lucasnoce/TFG_LevelSensingDevice/Results/fig_placa_teste.jpeg

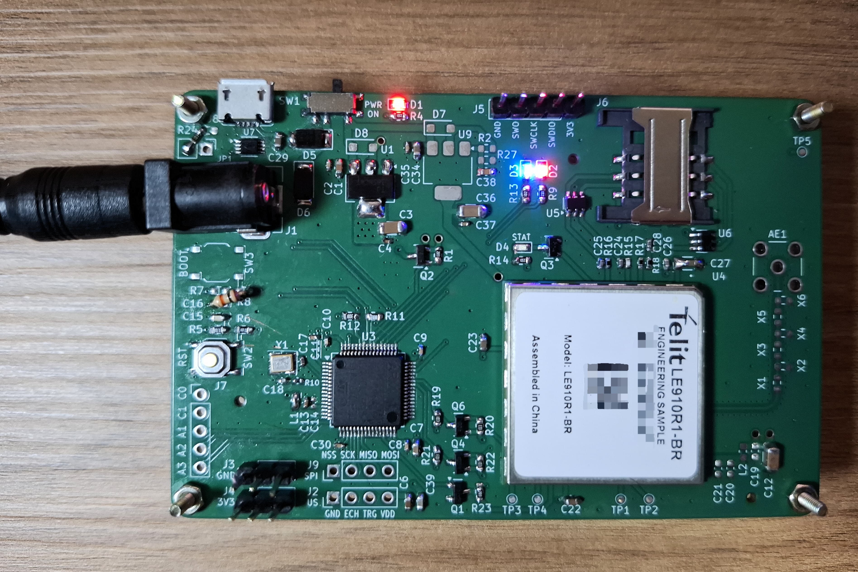
Results/fig_placa_teste.jpeg
