lucasnoce/TFG_LevelSensingDevice/README.md

# Level Sensing Device

Desenvolvido como meu Trabalho Final de Graduação, este dispositivo foi projetado para realizar medições de nível utilizando diferentes sensores, como sensores de Tempo de Voo (TOF) e Ultrassônicos. Ele também integra um modem LTE para transmitir os dados de medição por meio das tecnologias 4G e 2G. Além dos sensores de nível, o dispositivo também conta com um sensor de temperatura/umidade para melhorar o desempenho do sensoriamento ultrassônico.

Para informações mais detalhadas, consulte o [artigo completo](Results/Artigo_rev9.pdf).

---

Developed for my final Graduation Project, this device is designed to take level measurements using different sensors such as Time Of Flight (TOF) and Ultrasonic sensors. It also integrates an LTE modem to transmit the measurement data through 4G and 2G technologies. Besides de level sensors, the device also features a temperature/humidity sensor to help provide better ultrasonic sensing performance.

For more detailed information, please refer to the detailed [paper](Results/Artigo_rev9.pdf).
