lucasnoce/TFG_LevelSensingDevice/Results/Artigo_rev9.pdf

# Desenvolvimento de Dispositivo IoT para Monitoramento de Recursos Hídricos

Lucas A. Noce
Instituto de Engenharia de Sistemas e Tecnologia da Informaçaõ Universidade Federal de Itajubá Itajuba, MG ´
lucas.noce@unifei.edu.br
Decio Renn ´ | o M. Faria ´
Instituto de Engenharia de Sistemas e Tecnologia da Informaçaõ Universidade Federal de Itajubá Itajuba, MG ´
deciorenno@unifei.edu.br

Resumo—O avanço da Internet das Coisas (IoT) tem impulsionado a integraçao de conectividade em sensores inteligentes, ˜ especialmente em dispositivos autonomos projetados para o ˆ monitoramento remoto de locais de difícil acesso. Novas tecnologias de comunicaçao m ˜ ovel vem sendo desenvolvidas com ´ foco nesses equipamentos, visando o equilíbrio entre consumo e taxa de dados. Dentre essas aplicaçoes, o gerenciamento de ˜ recursos hídricos tem ganhado relevancia por conta da crescente ˆ demanda por soluçoes de monitoramento ambiental, decorrente ˜
da intensificaçao das emerg ˜ | encias clim ˆ | aticas. Nesse sentido, o ´
presente trabalho apresenta o desenvolvimento de um dispositivo
versatil voltado ´ | a supervis ` | ao remota de recursos h ˜ | ídricos.
Palavras-chave—Sensor de nível, Monitoramento remoto, Internet das Coisas.
Abstract—Advances in the development of the Internet of Things (IoT) have driven the integration of connectivity into smart sensors, especially in autonomous devices designed for remote monitoring of hard-to-reach locations. New mobile communication technologies have been developed with a focus on these devices, aiming to balance consumption and data rate. Among these applications, water resource management has gained relevance due to the growing demand for environmental monitoring solutions, resulting from the intensification of climate emergencies. In this sense, this paper will develop a versatile device aimed at remote supervision of water resources. Keywords—Level sensor, Remote monitoring, Internet of Things.
I. INTRODUÇ AÕ

A Internet das Coisas (IoT) tem se destacado como uma area ´ importante da tecnologia, permitindo a integraçao de diversos ˜ dispositivos e sensores para coletar e transmitir dados de maneira eficaz [1]. Neste contexto, a capacidade de monitorar e controlar variaveis ambientais de forma remota tem se ´ mostrado cada vez mais valiosa [2].
Esta crescente importancia da IoT se reflete na demanda ˆ
por soluçoes que ofereçam n ˜ | ao apenas conectividade, mas ˜
tambem precis ´ | ao e confiabilidade na coleta e transmiss ˜ | ao de ˜
dados [3]. Em locais de difícil acesso, como zonas rurais, ambientes industriais complexos ou areas geograficamente ´ isoladas, a capacidade de monitorar remotamente variaveis ´ ambientais se torna crucial para a manutençao da segurança, ˜
eficiencia e sustentabilidade das operaç ˆ | oes [ ˜ | 4]. Ate mesmo ´

Este projeto foi parcialmente viabilizado pela empresa Telit Cinterion, que forneceu o modem LE910R1BR utilizado durante o desenvolvimento.

as regioes urbanas t ˜ | em sofrido cada vez mais com os efeitos ˆ
das emergencias clim ˆ | aticas e buscado implementar soluç ´ | oes ˜
voltadas ao escoamento urbano que se beneficiam do monitoramento remoto contínuo [5].
Isso porque o monitoramento de recursos hídricos, que
consiste na coleta e analise de dados relacionados ´ | a qualidade, `
quantidade e dinamica da ˆ | agua em diferentes ambientes, ´
e essencial para a gest ´ | ao sustent ˜ | avel desses recursos [ ´ | 6],
permitindo identificar mudanças no nível da agua, prever ´ enchentes e avaliar a disponibilidade hídrica. Por conta disso,
essas soluçoes s ˜ | ao muito utilizadas em diversas aplicaç ˜ | oes ˜
como no acompanhamento do nível de reservatorios para ´
abastecimento publico, detecç ´ | ao de variaç ˜ | oes em rios para ˜
prevenir desastres naturais e controle de sistemas de irrigaçaõ
em areas agr ´ | ícolas [7].
| Nesse sentido, a integraçao desses dispositivos de moni- ˜
toramento com tecnologias de comunicaçao sem fio, como ˜ GSM (Global System for Mobile Communications, tecnologia de 2G amplamente utilizada para transmissao de dados ˜
em regioes remotas) e LTE ( ˜ | Long-Term Evolution, padraõ
de comunicaçao m ˜ | ovel de 4G que combina alta velocidade ´
com maior eficiencia energ ˆ | etica para IoT) se torna essencial. ´
Quando alinhadas a plataformas de gerenciamento de dados, essas tecnologias desempenham um papel fundamental na
organizaçao e interpretaç ˜ | ao dos dados, garantindo que as ˜
informaçoes sejam disponibilizadas de forma oportuna para ˜
os responsaveis pela operaç ´ | ao [ ˜ | 8].
| Essas capacidades sao especialmente importantes em ˜
aplicaçoes como a gest ˜ | ao de recursos h ˜ | ídricos, onde o moni-
toramento contínuo de parametros como temperatura, umidade ˆ
e nível da agua de rios e reservat ´ | orios pode contribuir para a ´
prevençao e mitigaç ˜ | ao de desastres naturais, otimizar o uso ˜
dos recursos e garantir o abastecimento adequado [9], [10]. Em processos industriais, a coleta constante de dados de nível de tanques e essencial para manter a qualidade e continuidade ´
da produçao e a segurança dos trabalhadores [ ˜ | 11].
| Nesse sentido, a implementaçao de sensores distribu ˜ | | ídos
conectados a uma rede central permite a obtençao de uma ˜
visao hol ˜ | ística e em tempo real das condiçoes do ambiente, o ˜
que e fundamental para a tomada r ´ | apida de decis ´ | oes e destaca ˜
a relevancia deste trabalho. ˆ

II. PROPOSTA

Este trabalho propoe o desenvolvimento de um dispositivo ˜ IoT capaz de realizar o monitoramento remoto do nível de líquidos em ambientes variados, especialmente em locais onde
a coleta manual e consistente de dados e invi ´ | avel, como ´
areas de dif ´ | ícil acesso, regioes remotas e instalaç ˜ | | oes indus- ˜
triais. O dispositivo projetado coleta dados e os transmite periodicamente para uma plataforma central, onde podem ser
interpretados e utilizados para analises e tomadas de decis ´ | ao. ˜
O sistema consiste na utilizaçao de um sensor ultrass ˜ | onico, ˆ
que e respons ´ | avel por realizar mediç ´ | oes de dist ˜ | ancia entre ˆ
o transdutor e a superfície livre, isto e, a regi ´ | ao lim ˜ | ítrofe
entre o ar e o líquido. A partir disso, o nível do líquido pode ser estimado com base no posicionamento e na altura de
instalaçao do transdutor. Por n ˜ | ao apresentar nenhum tipo de ˜
contato direto entre o sensor e o líquido, este metodo aumenta ´ a aplicabilidade do dispositivo, ja que pode ser utilizado para ´
mediçao dos mais diversos tipos de l ˜ | íquidos sem sofrer com
eventuais degradaçoes oriundas deste contato [ ˜ | 12]. O uso
do sensor ultrassonico no dispositivo tamb ˆ | em o torna um ´
equipamento de facil instalaç ´ | ao, bastando que haja visada ˜
direta entre o transdutor e o líquido.
Alem dessa aplicaç ´ | ao, um sensor de temperatura e umidade ˜
e utilizado para monitoramento das condiç ´ | oes ambientais, ˜
que tem um impacto consider ˆ | avel na velocidade do som ´
[13], afetando diretamente os resultados obtidos pelo sensor ultrassonico. ˆ
Neste projeto tambem´ | e usado um modem de comunicaç ´ | aõ
movel para viabilizar a transmiss ´ | ao dos dados coletados pelo ˜
dispositivo. Este modem, por utilizar redes LTE Cat 1 bis e ser compatível com redes 2G, possui uma cobertura abrangente e baixo custo de operaçao, fato que torna essas tecnologias muito ˜
utilizadas em aplicaçoes de IoT [ ˜ | 14]. Os dados podem ser
transmitidos para uma plataforma central de monitoramento, onde podem ser organizados e visualizados em uma interface acessível para o usuario final. ´
Um microcontrolador e respons ´ | avel por processar e ar- ´
mazenar as leituras dos sensores e requisitar a transmissaõ das informaçoes, garantindo que o dispositivo funcione de ˜ maneira autonoma e com baixo consumo de energia, ideal ˆ
para operaçoes em ˜ | areas de dif ´ | ícil acesso.
Assim, este projeto atende a uma necessidade crescente de sistemas IoT robustos e de baixo custo para monitoramento ambiental. Em um contexto de crescente preocupaçao com a ˜
sustentabilidade e a gestao de recursos naturais, essa soluç ˜ | aõ
permite a supervisao em tempo real das condiç ˜ | oes locais, ˜
contribuindo diretamente para a segurança e eficiencia em ˆ setores que dependem de monitoramento contínuo, como o gerenciamento de represas, reservatorios e tanques industriais. ´
| | III. DESENVOLVIMENTO
Nesta seçao, s ˜ | ao apresentados os detalhes t ˜ | ecnicos e ´
as etapas de projeto do dispositivo IoT proposto. Inicialmente, discutem-se os componentes utilizados em cada subcircuito, incluindo os sensores, microcontrolador, modulo de ´
comunicaçao e circuito de alimentaç ˜ | ao. Em seguida, aborda- ˜
se o processo de integraçao dos componentes e desenho da ˜ PCB (Printed Circuit Board). Por fim, e tratado o processo de ´ desenvolvimento do firmware inicial, detalhando as principais
funçoes e interaç ˜ | oes no dispositivo. Essa seç ˜ | ao visa oferecer ˜
uma visao completa do desenvolvimento e demonstrar como ˜ o sistema foi projetado para cumprir os requisitos de monitoramento remoto e transmissao de dados. ˜
As etapas de projeto do esquema eletrico e de desenho ´ da PCB foram desenvolvidas com auxílio do software KiCad e a programaçao do ˜ firmware inicial foi feita atraves do ´ software STM32CubeIDE. Todos os arquivos relacionados
se encontram em um repositorio no GitHub [ ´ | 15] e algumas
imagens do projeto constam em apendice. ˆ
A. Principais Componentes Utilizados
1) Sensor de Distancia: ˆ | O sensor de distancia ˆ | e um dos ´
principais componentes do projeto, pois e o respons ´ | avel ´
por realizar as mediçoes necess ˜ | arias para estimar o n ´ | ível
do líquido monitorado. Como mencionado anteriormente, foi
escolhido um sensor de distancia ultrass ˆ | onico pela facilidade ˆ
de instalaçao nos mais diversos locais, al ˜ | em da sua capacidade ´
de realizar as mediçoes sem ter contato f ˜ | ísico direto com
a agua. O desenvolvimento deste dispositivo foi pensado de ´ forma a ser compatível com mais de um modelo de sensor ultrassonico, como descrito a seguir. ˆ
O modelo escolhido para este projeto foi o modulo AJ- ´ SR04M, que dispoe de todos os componentes e circuitos ˜
necessarios para utilizar o transdutor ultrass ´ | onico acoplado a ˆ
ele. Este dispositivo possui 4 pinos para sua operaçao, sendo ˜ 2 pinos de alimentaçao (VCC e GND) e os outros 2 para ˜
comunicaçao com o microcontrolador. Essa configuraç ˜ | ao de ˜
4 pinos para operaçaõ e comum em v ´ | arios outros sensores ´
de distancia (especialmente nos ultrass ˆ | onicos) e, por isso, ˆ
o hardware deste projeto e compat ´ | ível com outros modelos
de sensores, bastando alguns ajustes na implementaçao do ˜ firmware.
Para otimizar o consumo de enrgia do dispositivo, o modulo ´ AJ-SR04M foi configurado para operar no metodo de largura ´ de pulso de baixo consumo [16]. Neste modo, os pinos
de comunicaçao s ˜ | ao chamados de TRIG (gatilho, do ingl ˜ | esˆ
trigger) e ECHO (eco, do inglesˆ echo) por conta da funçaõ desempenhada por cada um. O primeiro (TRIG) e usado ´ pelo microcontrolador para acionar o modulo e requisitar uma ´
mediçao, enquanto o pino ECHO ˜ | e usado pelo m ´ | odulo para ´
indicar o Tempo de Voo (na sigla em ingles, TOF) - ou seja, ˆ o período decorrido entre a emissao do trem de pulsos de ˜ ultrassom e o retorno do primeiro trem de pulsos refletido.
2) Sensor de Temperatura e Umidade Relativa: Os sensores
de distancia ultrass ˆ | onicos emitem um trem de pulsos sonoros ˆ
em frequencias inaud ˆ | íveis pelo ser humano (no caso do AJ-
SR04M, 40kHz) e medem com precisao o intervalo de tempo ˜
entre a transmissao e a recepç ˜ | ao desse sinal [ ˜ | 12]. Um ponto
negativo deste tipo de sensor e que as medidas realizadas ´ dependem fortemente da velocidade do som no instante da mediçao e ao longo do trajeto que o trem de pulsos percorre ˜

[17]. Isso se da pelo fato de que o sinal emitido pelo transdutor ´
ultrassonico ˆ | e uma onda mec ´ | anica e, portanto, a densidade do ˆ
meio de propagaçao - neste caso, o ar - tem grande influ ˜ | encia ˆ
na velocidade de propagaçao da onda [ ˜ | 13].
Uma forma de mitigar esse efeito e medir alguns par ´ | ametros ˆ
climaticos locais pr ´ | oximos a uma mediç ´ | ao de dist ˜ | ancia e ˆ
calcular a velocidade do som levando em conta os efeitos desses fatores [18], conforme as equaçoes a seguir. A ve- ˜ locidade de propagaçao do som no ar depende fortemente da ˜
temperatura, umidade relativa e pressao atmosf ˜ | erica, e, como ´
esses parametros podem variar significativamente em um curto ˆ
período, as mediçoes de dist ˜ | ancia podem apresentar grandes ˆ
erros caso esses indicadores nao sejam utilizados na estimativa ˜ da velocidade.

c0(T, P, xw, xc) = a0 + a1 · T + a2 · T

| | | 2
| | +(a3 + a4 · T + a5 · T

2
) · xw
| | +(a6 + a7 · T + a8 · T

2
) · P
| | +(a9 + a10 · T + a11 · T

2
) · xc
+a12 · x

2
| w + a13 · P

2 + a14 · x

2
c + a15 · xw · xc · P

(1)

xw = h · f ·

Psv
P

(2)

f = 1, 00062 + 3, 14 · P · 10⁻⁸ + 5, 6 · T
2
- 10⁻⁷
(3)

Psv = exp
1, 2811805 · T

2

- 10⁻⁵
−1, 9509874 · T · 10⁻² + 34, 04926034

−

6, 3536311 · 10⁻³
T
| (4)

Por exemplo, ao medir a altura de um objeto podemos obter uma leitura do sensor ultrassonico de 2,9 milissegundos. Se ˆ considerarmos a velocidade do som igual a 340m/s (valor
medio comumente utilizado), a leitura corresponder ´ | a a uma ´
distancia de 1 metro (Eq. ˆ | 6). No entanto, se as condiçoes ˜
locais de temperatura e umidade relativa forem de 25◦C e 50%, respectivamente, e utilizarmos esses valores para estimar a velocidade do som [18] no local, obteremos cerca de 347m/s para a velocidade e um resultado proximo de 1,02 metros para ´
a distancia (Eq. ˆ | 7). Em situaçoes de monitoramento de rios, ˜
lagos ou grandes tanques, essa pequena diferença na distancia ˆ
pode significar uma variaçao muito grande no volume de ˜ | agua, ´
o que demonstra a necessidade de se utilizar as condiçoes ˜ climaticas na estimativa da velocidade do som. ´

V =

∆S
∆t
=⇒ ∆S = V · ∆t | (5)
∆S = 340 · 2, 9 · 10⁻³ ≈ 1m | (6)
∆S = 347 · 2, 9 · 10⁻³ ≈ 1, 02m | (7)

Por conta disso, este projeto conta com um sensor de temperatura e umidade relativa do ar, permitindo que as
medidas de distancia sofram menos flutuaç ˆ | oes. Os dados de ˜
pressao atmosf ˜ | erica n ´ | ao s ˜ | ao coletados pelo dispositivo por ˜

terem uma menor influencia na variaçao da velocidade do som ˜
em relaçaõ as outras duas vari ` | aveis clim ´ | aticas citadas [ ´ | 13].
O sensor de temperatura e umidade relativa escolhido para este projeto e o AHT20, que se comunica com o microcon- ´ trolador atraves de um barramento I2C. Este sensor tem uma ´ ampla janela de trabalho, podendo operar em condiçoes de 0 a ˜ 100% da umidade relativa (RH) e de −40 a 85◦C [19]. Alem´
disso, possui otimos par ´ | ametros de performance, como um ˆ
erro típico de apenas ±2%RH para a umidade e de ±0, 3
| | | ◦C
para a temperatura.
3) Modulo de Comunicaç ´ | ao M ˜ | ovel: ´ | Para assegurar a
conectividade do dispositivo, este projeto utiliza o modem LE910R1BR, fabricado pela Telit Cinterion [20]. Esse modulo ´ e baseado na tecnologia LTE Cat 1 bis, uma variante da LTE ´ Cat 1 desenvolvida pela 3GPP na Release 13 e projetada es-
pecificamente para aplicaçoes IoT [ ˜ | | 21]. Alem disso, o modem ´
e compat ´ | ível com redes 2G, possibilitando conectividade em
regioes onde a cobertura LTE ˜ | e limitada ou inexistente. ´
A tecnologia Cat 1 bis mantem as caracter ´ | ísticas de de-
sempenho da Cat 1 original, como taxa de dados, largura de
banda e latencia, al ˆ | em de operar sobre a mesma infraestrutura ´
de rede. No entanto, sua principal vantagem esta na utilizaç ´ | aõ
de apenas uma antena para transmissao, o que reduz custos ˜ e simplifica o design do dispositivo sem comprometer a
eficiencia da comunicaç ˆ | ao [ ˜ | 14].
4) Microcontrolador: Para integrar e controlar todos os componentes do projeto, foi escolhido o microcontrolador STM32F103RBT6, da STMicroelectronics [22]. Esse dispositivo possui uma arquitetura de 32 bits baseada no nucleo ARM ´ Cortex-M3, oferecendo um equilíbrio entre desempenho e
eficiencia energ ˆ | etica, ideal para aplicaç ´ | oes em IoT que exigem ˜
processamento rapido e consumo reduzido. Contando com ´
varias portas digitais (GPIOs) e diversos perif ´ | | | ericos integrados, ´
como interfaces para comunicaçao USB, UART e I2C, o ˜ STM32F103RBT6 permite uma comunicaçao eficiente com ˜ todos os componentes escolhidos.
O microcontrolador STM32F103RBT6 conta com recursos de gerenciamento de energia, que possibilitam a operaçao em ˜ diferentes modos de consumo, adequando-se as necessidades ` do dispositivo conforme o contexto de uso. Essa flexibilidade é essencial para aplicaçoes em locais remotos, onde a disponi- ˜ bilidade de energia pode ser limitada. O STM32F103RBT6
tambem conta com uma mem ´ | oria ´ | flash interna de 128KB,
que pode ser parcialmente utilizada para armazenar dados
historicos das mediç ´ | oes, contribuindo para o desempenho do ˜
dispositivo.
B. Projeto do Esquema Eletrico ´

O esquema eletrico do dispositivo foi elaborado de acordo ´ com as especificaçoes t ˜ ecnicas fornecidas pelos fabricantes de ´ cada componente. A seguir sao apresentados os subcircuitos ˜ que compoem o dispositivo e os detalhes do desenvolvimento ˜ do projeto. A Fig. 1 ilustra as conexoes entre cada subcircuito, ˜
sendo as setas em laranja correspondentes as ligaç ` | oes de ˜
alimentaçao e em preto as relacionadas ˜ | | as trilhas de sinal. `

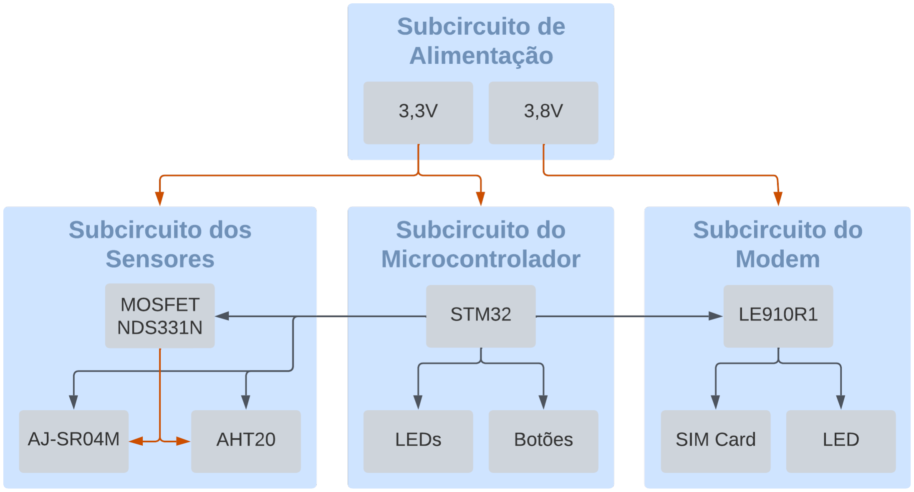
[picture p2: figure]

Fig. 1. Diagrama de conexoes do circuito ˜

1) Subcircuito | de | Alimentaçao: ˜ | O | subcircuito | de
alimentaçao (Ap ˜ | endice ˆ | A) e o respons ´ | avel por fornecer ´
as tensoes e correntes necess ˜ | | arias para a correta operaç ´ | | ao do ˜
dispositivo. Para cumprir com esse objetivo, foi levantado o consumo maximo de cada componente utilizado no projeto, ´ de acordo com os datasheets. Dispositivos com consumo abaixo de 1mA foram desconsiderados nesta analise. A ´ tabela I mostra as características de alimentaçao desses ˜ componentes.
| | TABELA I
ANALISE DE ´ | CONSUMO DOS COMPONENTES
Componente | Tensão nominal [V] | Consumo máximo [mA]
LE910R1BR | 3,8 | 550
STM32F103RBT6 | 3,3 | 50
LED vermelho | 3,3 | 25
LED azul | 3,3 | 20
AJ-SR04M | 3,3 | 2,5
AHT20 | 3,3 | 1
A partir desses dados, e poss ´ | ível perceber que o subcircuito
de alimentaçao deve fornecer duas tens ˜ | oes reguladas: 3,8V e ˜
3,3V. Alem disso, deve ser capaz de entregar no m ´ | ínimo 550
mA de corrente para o circuito de 3,8V e 98,5 mA para o circuito 3,3V (ja que o projeto possui 2 LEDs vermelhos e 2 ´
azuis), em condiçoes de consumo m ˜ | aximo em regime perma- ´
nente. Para alimentar os outros componentes nao considerados ˜
nesta analise, os transientes de corrente durante a operaç ´ | ao do ˜
dispositivo e demais perdas do circuito, foi acrescentada uma margem de segurança.
Para este projeto, foram escolhidos dois reguladores de tensao do tipo LDO da Texas Instruments: para o circuito de ˜ 3,3V foi selecionado o TLV1117-33 e para 3,8V foi escolhido
o TLV1117-ADJ. Ambos sao capazes de entregar at ˜ | e 1,2A ´
de corrente (valor típico [23]) e, portanto superam os valores mínimos necessarios do dispositivo. ´
O TLV1117-33 possui uma saída fixa de 3,3V e requer
apenas a adiçao de capacitores na entrada e na sa ˜ | ída para filtrar
ruídos e assegurar maior estabilidade na tensao e na corrente ˜
de saída. Ja o TLV1117-ADJ, ´ | e um regulador de tens ´ | aõ
ajustavel e ´ | e necess ´ | ario selecionar corretamente os resistores ´
de ajuste para garantir que a tensao desejada seja regulada ˜ na saída. O valor desses resistores foi calculado seguindo as
recomendaçoes do ˜ | datasheet, como mostrado a seguir. Para
este componente, os valores padrao de ˜ | VREF e IADJ sao de ˜
1, 25V e 80µA, respectivamente [23]. Foi determinado um
valor arbitrario de ´ | 21kΩ para o resistor R2. Tambem foram ´
adicionados diodos de proteçao aos dois reguladores, como ˜ recomendado pelo datasheet.

VOUT = VREF ·

1 +

R2
R1
+ (IADJ · R2) (8)

R1 =

VREF · R2
VOUT − VREF − (IADJ · R2) | (9)

R1 =

1, 25 · 21k
3, 8 − 1, 25 − (80µ · 21k)

(10)

∴ R1 ≈ 30kΩ | (11)
Alem dos reguladores, o subcircuito de alimentaç ´ | | | | | | | ao possui ˜
uma chave que liga ou desliga a alimentaçao de todo o circuito ˜
e conta com duas formas de alimentaçao: atrav ˜ | es de um ´
conector do tipo barrel jack e de um conector micro USB. Em
cada conexao foi adicionado um diodo ˜ | schottky para proteger
a placa contra alimentaçao com polaridade reversa e tamb ˜ | em´
para possibilitar a utilizaçao simult ˜ | anea dos dois m ˆ | etodos de ´
alimentaçao. Caso a tens ˜ | ao de entrada de um dos conectores ˜
seja maior que a do outro, o diodo da linha de menor tensaõ sera reversamente polarizado, permitindo que apenas a fonte ´ de maior tensao alimente o circuito. ˜
O conector micro USB tambem est ´ a ligado ao microcon- ´ trolador para permitir transferencia de dados, como envio ˆ de mensagens para debug de firmware, por exemplo. Essa
conexaõ e feita atrav ´ | es do circuito integrado TXS0102DCU ´
[24], que fornece proteçao contra ESD ( ˜ | Electrostatic Dis-
charge) e realiza a traduçao entre os n ˜ | íveis de tensao 5V e ˜
3,3V, garantindo a compatibilidade entre o microcontrolador e o dispositivo USB conectado.
O subcircuito de alimentaçao tamb ˜ | em possui um LED que ´
indica se a placa esta alimentada com 3,3V e duas barras de ´ pinos com os níveis GND e 3,3V, que facilitam a mediçao das ˜ tensoes. ˜
2) Subcircuito do Microcontrolador: O subcircuito do microcontrolador (Apendice ˆ B) contem os componentes impor- ´ tantes para o funcionamento do microcontrolador e dos outros dispositivos conectados a ele. Primeiramente foram adicionados capacitores de desacoplamento em cada um dos pinos de alimentaçao do microcontrolador, conforme indicado no ˜
datasheet [22]. Esses capacitores sao respons ˜ | aveis por filtrar ´
eventuais oscilaçoes de tens ˜ | ao, garantindo maior estabilidade ˜
na alimentaçao do dispositivo. ˜
O | pino | de | alimentaçao | VDDA ˜ | e | respons ´ | avel ´
pela | alimentaçao | de | v ˜ | arios | perif ´ | ericos | internos | do ´
STM32F103RBT6, incluindo os subcircuitos de ADCs, PLL e osciladores RC internos [22]. Por se tratarem de circuitos sensíveis a ruídos, foi incluída mais uma etapa de
filtragem nesse pino atraves da adiç ´ | ao de um indutor de 39nH ˜
em serie. ´

Foi adicionado o cristal oscilador ao subcircuito do mi-
crocontrolador, responsavel por fornecer uma fonte de ´ | clock
estavel e precisa. Para este projeto, foi escolhido um cristal ´ oscilador de 16MHz, que e o maior valor suportado pelo ´ STM32F103RBT6 de acordo com o datasheet [22].
O subcircuito do microcontrolador conta com dois botoes ˜ para os sinais de reset e boot, responsaveis por reiniciar o ´ microcontrolador e selecionar o modo de inicializaçao do dis- ˜ positivo, respectivamente. Alem disso, o circuito possui dois ´ LEDs ligados a duas GPIOs do microcontrolador, 5 GPIOs e barramento SPI externalizados para uso eventual e dois resistores pull-up conectados aos dois pinos do barramento I2C necessarios para o funcionamento do protocolo, conforme ´ recomendado pelo datasheet [22].
Tambem possui uma barra de 5 pinos conectados ao microcontrolador para permitir a gravaçao do ˜ firmware atraves´ de uma interface SWD. Este protocolo de gravaçao utiliza um ˜ pino para clock (SWCLK) e outro para transferencia de dados ˆ (SWDIO). Um terceiro pino (SWO) pode ser utilizado opcionalmente para que o microcontrolador envie alguns dados, muito utilizado para debug.
3) Subcircuito dos Sensores: Este subcircuito possui os dois sensores utilizados no projeto e um transistor responsavel ´ por habilitar o fornecimento de energia para os dispositivos
(Apendice ˆ | C). O transistor utilizado e o AO3401A [ ´ | 25], um
MOSFET canal P de intensificaçao ( ˜ | enhancement). Um fator
importante deste componente a se destacar e que seu limiar ´ de acionamento da porta (gate threshold, VGS(th)
) e de apenas ´
−1V , alem de possuir uma alta capacidade de corrente no ´ dreno (suporta uma corrente ID de até −4, 2A), que viabiliza
sua utilizaçao para chaveamento de pot ˜ | encia. ˆ
O MOSFET foi conectado de forma que a fonte (source)
esta ligada ´ | a alimentaç ` | ao da placa (3,3V), o dreno ( ˜ | drain)
esta ligado aos pinos de alimentaç ´ | ao de cada sensor (VDD) e a ˜
porta (gate) esta conectada a uma GPIO do STM32F103RBT6. ´ Dessa forma, o microcontrolador pode habilitar a alimentaçaõ dos sensores ao levar a tensao na porta do transistor para 0V ˜
(VGS = −3, 3V ) ou desabilitar a alimentaçao levando a tens ˜ | aõ
a 3,3V (VGS = 0V ). Para que o estado do transistor nao seja ˜ indeterminado em nenhum momento, um resistor de 20kΩ é conectado como pull-up na porta do MOSFET, fazendo com que o transistor seja cortado por padrao. ˜
O sensor de distancia AJ-SR04M ˆ | e ligado ´ | a PCB atrav ` | es de ´
uma barra de pinos que conecta os dois pinos responsaveis pela ´
operaçao do m ˜ | odulo a duas GPIOs do microcontrolador. Os ´
outros dois pinos do sensor, relacionados a alimentaç ` | ao, s ˜ | aõ
conectados ao GND e VDD. Para evitar grandes variaçoes de ˜
tensao, dois capacitores de desacoplamento s ˜ | ao conectados ao ˜
pino VDD do modulo. ´
Por fim, o sensor de temperatura e umidade relativa AHT20
e conectado ao barramento I2C para comunicaç ´ | ao com o ˜
microcontrolador e seus pinos de alimentaçao s ˜ | ao conectados ˜
ao GND e VDD. Seguindo as recomendaçoes do ˜ | datasheet
[19], um resistor de 330Ω foi ligado em serie com o pino ´ VDD, alem de dois capacitores de desacoplamento. ´
4) Subcircuito do Modem: Este subcircuito possui diversos componentes para garantir o correto funcionamento do
LE910R1BR (Apendice ˆ | D). Primeiramente, a alimentaçaõ
de 3, 8V do modulo passa por uma etapa de filtragem re- ´ comendado pelo fabricante [20], que consiste em um filtro pi para reduzir o ruído de chaveamento produzido durante o
funcionamento do modem. Alem disso, esse m ´ | odulo possui ´
alguns perifericos externos que operam a uma tens ´ | ao de ˜ | 1, 8V ,
como a interface UART que sera utilizada. Por isso, um par ´ de capacitores de desacoplamento e utilizado nos dois pinos ´ de fornecimento dessa tensao (VAUX). ˜
O LE910R1BR pode ser ligado e desligado atraves de um ´
pulso de tensao no pino ˜ | ON OFF. Seguindo as recomendaçoes ˜
do datasheet, esse pino e controlado pelo microcontrolador ´ atraves de um MOSFET canal N. Neste projeto, foi utilizado ´ o MOSFET NDS331N, que tambem pode ser acionado dire- ´ tamente por uma GPIO.
Outro pino utilizado e o STAT ´ | LED, uma GPIO do proprio ´
modem que mostra o estado de operaçao do dispositivo e que ˜
e comumente conectado a um LED para uma indicaç ´ | ao facil- ˜
mente visível. Para que nao haja problemas de sobrecorrente ˜ no pino do modem, o LED e conectado a outro MOSFET ´ NDS331N.
A UART do modem trabalha a uma tensao de ˜ | 1, 8V que
naõ e diretamente compat ´ | ível com os 3, 3V de operaçao do ˜
STM32F103RBT6. Para torna-los compat ´ | íveis, foram projeta-
dos dois deslocadores de tensao ( ˜ | level shifters) baseados no
MOSFET NDS331N, um para cada pino utilizado da UART (RX e TX). Esse transistor foi escolhido por apresentar tempos de chaveamento baixos - o maior deles sendo o tempo de subida (tr) de apenas 50 ns [26] -, o que o torna viavel para ´
esta aplicaçao, uma vez que o ˜ | baudrate (taxa de transmissao) ˜
padrao da UART do modem ˜ | e de 115200 bps, que representa ´
um período de bit corresponde a 1/115200 ≈ 8, 7µs, cerca de 173 vezes maior que o tempo de chaveamento do transistor. O level shifter baseado em MOSFET e um circuito simples, ´
construído por meio da ligaçao da fonte ˜ | a menor tens ` | aõ
(LV, Low Voltage) e do dreno a maior tens ` | ao (HV, ˜ | High
Voltage), ambos atraves de resistores ´ | pull-up para as tensoes ˜
correspondentes. A porta do transistor e conectada diretamente ´ a LV, como mostra a Fig. 2. Dessa forma, se o dreno for conectado a uma entrada digital (RX), uma saída digital (TX) conectada a fonte pode saturar o MOSFET ao aplicar 0V, ` tornando a tensaõ VGS igual a LV e levando, portanto, o dreno para 0V. A saída TX pode tambem aplicar LV na fonte, o que ´ leva VGS para 0V, cortando o transistor e levando o dreno para HV por conta do resistor pull-up. Por outro lado, RX pode ser ligado a fonte e TX ao dreno. Assim, ao aplicar 0V no dreno, `
a fonte tambem´ | e levada para 0V, mantendo a saturaç ´ | ao do ˜
MOSFET ja que ´ | VGS = LV . Se o dreno for levado para HV,
a tensao na fonte cresce at ˜ | e atingir LV, momento em que ´ | VGS
se torna igual a 0, cortando o transistor e mantendo a fonte em LV por conta do resistor pull-up.
Para possibilitar as comunicaçoes por redes m ˜ | oveis, ´ | é
necessario conectar um SIM ´ | card ao LE910R1BR, que se co-
munica atraves de 3 pinos: um para ´ | clock (SIMCLK), um para

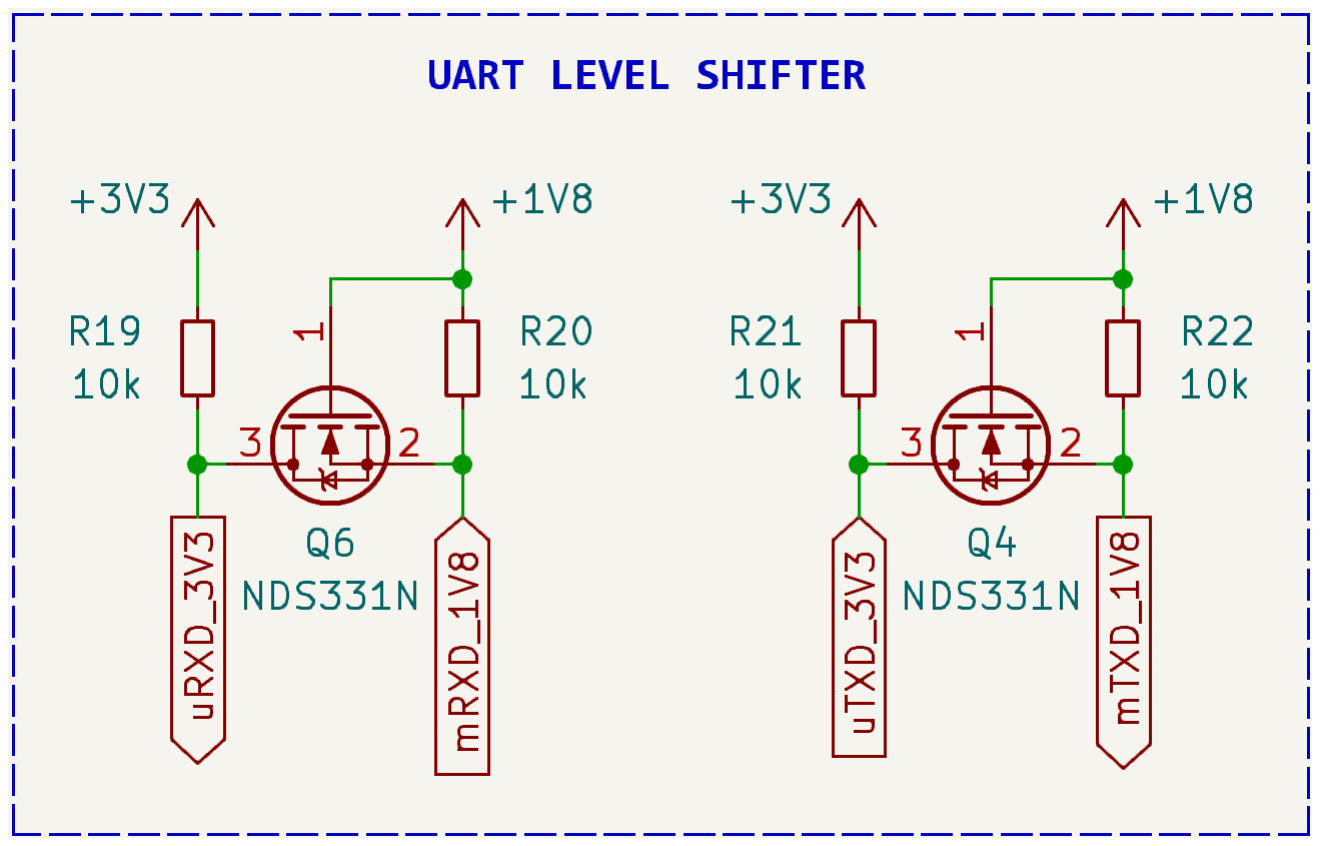
[picture p3: figure]

Fig. 2. Circuito level shifter da UART

dados (SIMIO) e um para reset do cartao. Por recomendaç ˜ | aõ
do datasheet do modem [20], capacitores de desacoplamento sao conectados a esses sinais e, para incrementar a filtragem ˜
desses sinais, foram tambem adicionados resistores de ´ | 22Ω
em serie nessas linhas. Vale ressaltar que o pino de dados ´ | é
conectado a um resistor pull-up tambem por recomendaç ´ | aõ
do fabricante. Alem disso, foram adicionados dois circuitos ´ integrados USBLC6-2SC6, que implementam uma proteçaõ contra descargas eletrostaticas (ESD) nas linhas por meio ´ de diodos TVS, aumentando a confiabilidade do dispositivo quanto ao manuseio do conector de SIM card.
O modem tambem necessita de uma antena para transmitir ´ e receber dados. Para isso, um conector SMA foi adicionado para facilitar a instalaçao da antena. Um filtro pi de dois ˜ estagios foi incorporado ao projeto sem valores calculados ´ para possibilitar um possível ajuste empírico da impedancia ˆ da trilha, caso necessario. ´
Alguns test points foram adicionados em pontos estrategicos ´ do modem para que seja possível a verificaçao desses sinais ˜ apos a solda do componente, uma vez que o LE910R1BR ´ possui um encapsulamento do tipo LGA, em que os pads saõ voltados para a parte de baixo do modulo. ´
C. Layout da PCB
Iniciou-se o desenho da PCB pela distribuiçao dos compo- ˜ nentes em pequenos grupos, de acordo com a funçao desem- ˜ penhada. Foi escolhido manter o subcircuito de alimentaçao na ˜ porçao superior esquerda da placa, permitindo que eventuais ˜ elevaçoes de temperatura dos reguladores tenham um menor ˜ impacto nos circuitos do microcontrolador e do modem,
posicionados em regioes mais distantes. O circuito de r ˜ | adio ´
frequencia (RF) foi posicionado na extremidade ˆ | a direita `
da placa, o mais distante possível de outros sinais de alta frequencia, como o cristal oscilador e o barramento SPI. ˆ
Alem disso, circuitos muito sens ´ | íveis a ruído, como o cristal
oscilador e a antena LTE, foram posicionados o mais proximo ´ possível das suas respectivas conexoes visando reduzir o ˜ comprimento das trilhas, como mostra a Fig. 3.
A placa foi desenvolvida com 4 camadas, sendo as duas camadas externas utilizadas para roteamento de sinais e plano GND e as duas internas utilizadas somente para distribuiçaõ

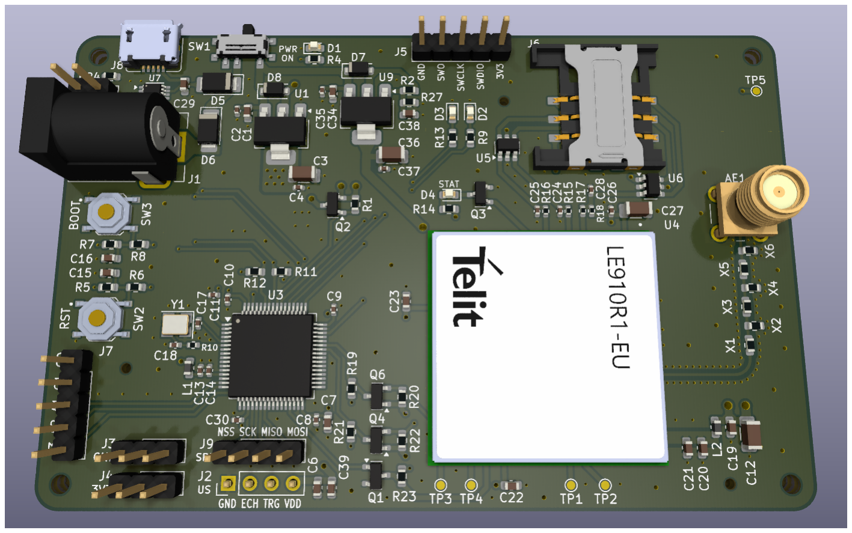
[picture p4: figure]

Fig. 3. Vista 3D do layout desenvolvido

de tensao (uma camada de plano GND e outra de plano 3,3V). ˜ A camada superior contem a maioria das trilhas de sinal, ´ incluindo o circuito da antena e, por isso, a camada interna de plano GND esta situada imediatamente abaixo da superior, ´ contribuindo na blindagem das trilhas aos ruídos de RF.
Para possibilitar uma melhor eficiencia na transfer ˆ | encia de ˆ
energia ao longo do circuito de RF, a largura da trilha que conecta a antena LTE ao modem foi calculada para garantir
uma impedancia de ˆ | 50Ω, conforme especificado no datasheet
do LE910R1BR [20]. Para isso, foi utilizada uma ferramenta disponibilizada pela fabricante da PCB, a JLCPCB [27]. Nessa
ferramenta, sao adicionadas informaç ˜ | oes de imped ˜ | ancia dese- ˆ
jada, tipo de trilha (neste caso, trilha coplanar de extremidade
unica), posicionamento das camadas do sinal e da refer ´ | encia e ˆ
distancia da trilha RF para o plano de refer ˆ | encia coplanar, al ˆ | em´
do stack-up da placa (que indica a ordenaçao e espessura das ˜ camadas e o material dieletrico utilizado entre cada camada ´ de cobre). Com isso, a trilha foi desenhada com a espessura calculada (de 0, 3424mm) e o espaçamento desejado para o
plano de referencia (de ˆ | 0, 5080mm).
Os terminais do modem e do conector SMA possuem dimensoes muito maiores que a largura da trilha e, por isso, ˜ foram adicionados teardrops nesses pontos. Um teardrop é uma forma geometrica trapezoidal desenhada nos pontos de ´
conexao de uma trilha para evitar que haja um ˜ | angulo reto ˆ
nessa regiao, o que pode gerar uma mudança muito brusca na ˜ impedancia da linha. Ao adicionar essas formas trapezoidais, ˆ
a alteraçao de imped ˜ | ancia se d ˆ | a de forma gradual, o que reduz ´
as reflexoes de sinal. ˜
Grande parte dos componentes - incluindo o modem e o
conector da antena - estao na camada superior, n ˜ | ao apenas ˜
para facilitar a montagem, mas tambem para garantir que a ´ maioria dos sinais sensíveis e de alta frequencia ficassem na ˆ mesma camada. O dispositivo foi projetado para ser instalado com esta face voltada para cima, facilitando a visualizaçao dos ˜ LEDs indicadores, a montagem da antena e demais conexoes. ˜ Alem disso, o sensor de temperatura e umidade relativa ´ foi posicionado na camada inferior para que as mediçoes de ˜ temperatura sejam menos impactadas pela variaçao t ˜ ermica ´ dos outros componentes durante a operaçao. O posicionamento ˜
das conexoes do sensor de dist ˜ | ancia tamb ˆ | em foi projetado para ´

que este fique voltado para baixo, facilitando a instalaçao do ˜
sensor e do transdutor, ja que, na maioria das aplicaç ´ | oes, a ˜
placa podera ser instalada acima da ´ | agua. ´
Por fim, todas as barras de pinos, conectores e test points foram posicionados nas extremidades da placa para facilitar sua utilizaçao e favorecer o acesso aos demais componentes. ˜
D. Firmware Inicial
| Foi desenvolvido uma versao inicial de ˜ | firmware [15] que
realiza mediçoes de dist ˜ | ancia corrigidas pela temperatura e ˆ
umidade relativa aferidas de acordo com as equaçoes ( ˜ | 1) a (4)
e transmite esses dados para a plataforma Tago. Este firmware tem como objetivo validar o funcionamento dos blocos de hardware e mostrar o dispositivo em operaçao. O programa ˜
e baseado em uma m ´ | aquina de estados c ´ | íclica (Fig. 4), em
que o dispositivo realiza mediçoes, transmite os dados e entra ˜ em modo de baixo consumo por um período, ate ser acordado ´ por um alarme interno.

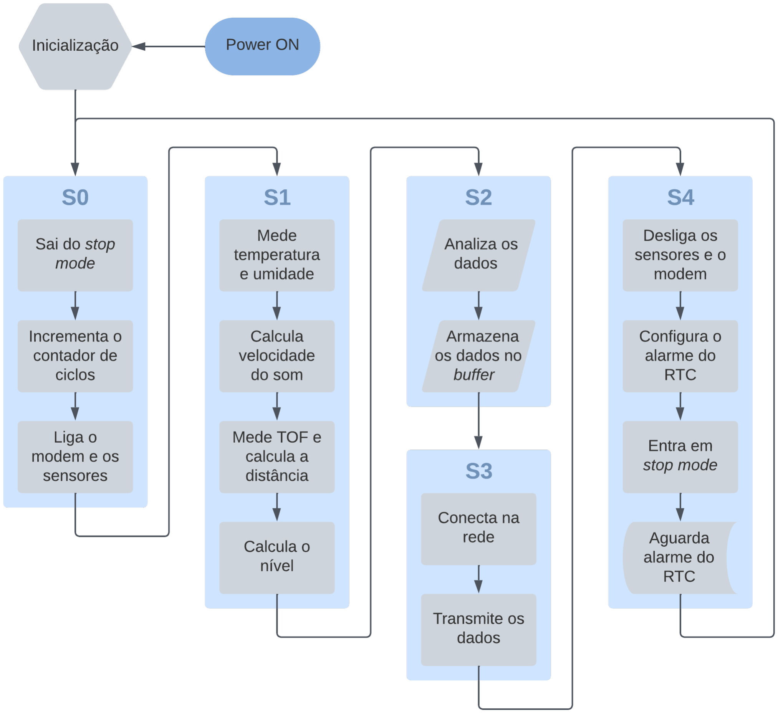
[picture p5: figure]

Fig. 4. Fluxograma do firmware

IV. RESULTADOS

A. Validaçao de Hardware ˜
Apos a fabricaç ´ | ao da placa, iniciou-se o processo de ˜
validaçao do ˜ | hardware pelo subcircuito de alimentaçao. Ap ˜ | os´
alguns testes, foi constatado que o componente recebido naõ correspondia ao modelo solicitado.
Visando solucionar o problema, uma nova abordagem foi
proposta, que consistiu na substituiçao do regulador ajust ˜ | avel ´
por um fixo de 3,3V. Para garantir que a tensao de sa ˜ | ída
continuasse proxima a 3,8V, o pino de refer ´ | encia GND do ˆ
novo regulador foi conectado em serie a um diodo polarizado ´ diretamente (Fig. 5). Dessa forma, a queda de tensao prduzida ˜ pelo diodo (de aproximadamente 0,5V no caso do 1N4002W) desloca a referencia do regulador de 0V para 0,5V, resultando ˆ
em uma tensao de sa ˜ | ída de 3, 3 + 0, 5 = 3, 8V .

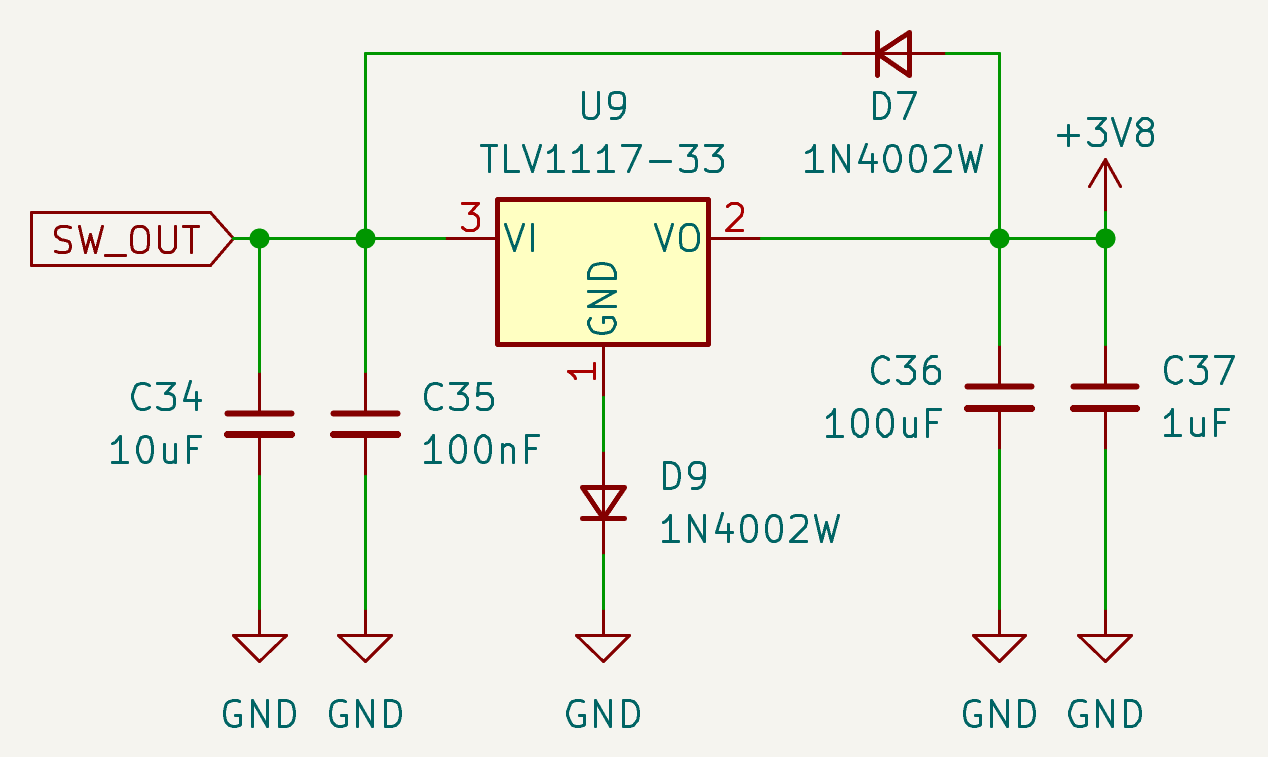
[picture p6: figure]

Fig. 5. Nova abordagem para a fonte 3,8V

Essa soluçao apresentou um bom funcionamento nos testes ˜
iniciais sem carga, mas apos a conex ´ | ao do modem, os de- ˜
mais testes voltaram a demonstrar resultados insatisfatorios, o ´ que evidenciou uma falha de projeto relacionada ao circuito
de alimentaçao do LE910R1BR. Ap ˜ | os revisitar o ´ | datasheet,
foram notados alguns detalhes nas recomendaçoes de projeto ˜
do circuito de alimentaçao que n ˜ | ao foram seguidos durante o ˜
desenvolvimento. O primeiro deles e relacionado aos picos de ´ corrente durante a operaçao do modem, que podem chegar a ˜ 2A, em especial durante transmissoes 2G (GSM/GPRS). ˜
Em conjunto com isto, as diretrizes de design de uma fonte com entrada de 5V e de 12V sao substancialmente diferentes. ˜ No caso da entrada de 5V, o datasheet recomenda a utilizaçaõ de uma fonte chaveada, mas argumenta que a diferença entre
as tensoes de entrada e de sa ˜ | ída (drop-out, neste caso de
5 − 3, 8 = 1, 2V ) e pequena e que, portanto, um regulador ´
LDO pode ser utilizado desde que soluçoes t ˜ | ermicas (como ´
dissipadores) sejam levados em consideraçao. Al ˜ | em disso, o ´
regulador recomendado pelo datasheet e um LT1528, que ´
possui corrente de saída maxima de at ´ | e 3A. J ´ | a no caso da ´
entrada de 12V, o documento discute que um regulador LDO naõ e recomendado e de que uma fonte chaveada deve ser ´
usada. Alem do mais, em ambos os casos ´ | e recomendado que ´
o capacitor presente na saída seja tolerante a 10V.
A fonte projetada neste trabalho para o modem foi baseada em um regulador LDO com corrente de saída maxima t ´ ípica de 1,2A, bem abaixo dos 2A de pico mencionados. No projeto inicial, a tensao de entrada do LDO poderia variar ˜ entre 5 e 15V, seguindo os limites descritos no datasheet do TLV1117-ADJ. Como discutido anteriormente, a utilizaçao de ˜ um regulador LDO para drop-outs maiores que 1,2V naõ é recomendada pelo datasheet do modem.
Levando estes pontos em consideraçao, fica evidente que ˜ o projeto do circuito de alimentaçao do LE910R1BR foi ˜
subdimensionado e que a soluçao mais recomendada ˜ | | e a ´
substituiçao do regulador LDO por uma fonte chaveada, como ˜ uma fonte buck que pode ser projetada para permitir tensoes ˜ de entrada compatíveis com as de projeto (5 a 15V) e fornecer a corrente necessaria para o funcionamento do modem. ´
Foi encontrado, ainda, outro erro de projeto relacionado à

implementaçao dos bot ˜ | oes de ˜ | boot e reset. De acordo com
o datasheet do STM32F103RBT6 [22], o microcontrolador
possui tres formas de ser inicializado dependendo do n ˆ | | ível de
tensao nos pinos BOOT0 e BOOT1 (PB2), como mostra a ˜ tabela II.
| | TABELA II
MODOS DE boot DO STM32F103RBT6
BOOT0 | BOOT1 | Inicialização
0 | x | Memória flash
1 | 0 | Memória ROM (bootloader)
1 | 1 | Memória SRAM
Como o metodo de gravaç ´ | ao escolhido para o projeto foi ˜
a interface SWD, e necess ´ | ario iniciar o microcontrolador pela ´
memoria ´ | flash, ou seja, o pino BOOT0 deve estar em nível
0V. No entanto, no projeto inicial esse pino fica com 3,3V por
padrao por conta do resistor de ˜ | pull-up R7. Fez-se necessaria ´
uma alteraçao do circuito, que consistiu na substituiç ˜ | ao deste ˜
circuito do botao por um resistor ˜ | pull-down de 10kΩ. Essa
e uma soluç ´ | ao simplificada que exclui a funcionalidade de ˜
seleçao, e em uma eventual vers ˜ | ao posterior do dispositivo, ˜
sugere-se um circuito como o ilustrado na Fig. 6.

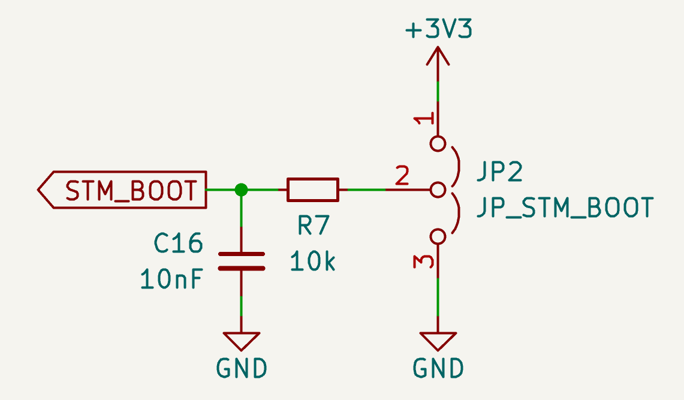
[picture p7: figure]

Fig. 6. Circuito sugerido para o pino BOOT0

B. Firmware de validaçaõ

Foi desenvolvido um firmware inicial para validaçao do ˜ funcionamento dos componentes. Cada um dos componentes principais (LEDs, sensores e modem) foi testado individualmente antes da integraçao de todas as funcionalidades em um ˜ unico c ´ odigo. Para esses testes, foi utilizada a funcionalidade ´ de debug do STM32CubeIDE, disponível atraves da interface ´ SWD. Assim, o programa pode ser executado linha a linha e pausado a qualquer momento, facilitando a depuraçao de ˜ codigo. ´
Os primeiros testes realizados tiveram como objetivo o controle dos LEDs conectados ao microcontrolador (Fig. 7). Em seguida, foi validado o funcionamento do sensor de temperatura e umidade relativa AHT20, que se comunica com o mi-
crocontrolador atraves do barramento I2C. Foram necess ´ | arios ´
alguns ajustes no programa para que a decodificaçao dos bits ˜ de leitura recebidos fossem interpretados corretamente e, ao final, o firmware foi capaz de requisitar mediçoes e traduzir ˜ as leituras em valores coerentes de temperatura e umidade. Com isso, o funcionamento do barramento I2C tambem foi ´ validado.


Fig. 7. Dispositivo em funcionamento durante testes de firmware

O proximo item testado foi o sensor ultrass ´ | onico, visando ˆ
a obtençao de dados de dist ˜ | ancia. Ap ˆ | os alguns ajustes no pro- ´
grama, foi possível realizar leituras a uma distancia controlada, ˆ
alcançando resultados muito proximos da dist ´ | ancia medida ˆ
com auxílio de uma fita metrica. ´
Na sequencia, foi testada a funcionalidade da m ˆ | aquina de ´
estados com ciclos temporizados de baixo consumo (stop mode). O dispositivo foi programado para realizar uma
mediçao (de temperatura umidade e dist ˜ | ancia) a cada 30 ˆ
segundos, desligando os sensores e entrando em stop mode durante o tempo ocioso. A operaçao desse ciclo foi validada ˜
atraves da observaç ´ | ao dos LEDs de indicaç ˜ | ao, que piscam a ˜
cada mediçao. ˜
Por conta dos problemas encontrados no circuito de
alimentaçao do modem, n ˜ | ao foi poss ˜ | ível realizar os testes
previstos de transmissao de dados para a plataforma ˜ | online
de monitoramento.
V. CONCLUSAÕ
Este trabalho apresentou o desenvolvimento de um dispositivo IoT para monitoramento remoto de recursos hídricos que pode ser aplicado em diversas situaçoes. Os testes realizados ˜ demonstraram que o sistema e capaz de coletar dados ambien- ´
tais com precisao e utiliz ˜ | a-los para aumentar a confiabilidade ´
das mediçoes de dist ˜ | ancia. A soluç ˆ | ao proposta contribui para a ˜
area de monitoramento ambiental, oferecendo um dispositivo ´ compacto e com baixo consumo de energia, características
sao essenciais para aplicaç ˜ | oes em locais remotos onde o ˜
acompanhamento contínuo e necess ´ | ario, mas as condiç ´ | oes de ˜
acesso e de comunicaçao s ˜ | ao limitadas. Os resultados obtidos ˜
reforçam o potencial de sistemas IoT na gestao de recursos ˜ naturais, especialmente considerando a crescente demanda por dados ambientais precisos para tomada de decisao em ˜
situaçoes de escassez h ˜ | ídrica e eventos climaticos extremos. ´

O dispositivo apresentou limitaçoes, principalmente rela- ˜
cionadas ao subcircuito de alimentaçao, que n ˜ | ao foi ca- ˜
paz de fornecer a energia necessaria para o funcionamento ´ do modem LTE. Tambem foram encontradas algumas out- ´
ras complicaçoes, especialmente no processo de validaç ˜ | aõ
de hardware, que puderam ser solucionadas com pequenos ajustes.
Estudos futuros podem explorar outras topologias para a fonte de alimentaçao de 3,8V, em especial utilizando fontes ˜ chaveadas. Este tipo de fonte apresenta uma melhor eficiencia ˆ
energetica em relaç ´ | ao aos LDOs e deve ser capaz de fornecer ˜
a potencia necess ˆ | aria para o modem. Trabalhos posteriores ´
tambem podem aplicar o circuito sugerido para a seleç ´ | ao do ˜
pino BOOT0 para solucionar definitivamente esta limitaçao. ˜
Dessa forma, este trabalho nao apenas ofereceu uma soluç ˜ | aõ
para o monitoramento de recursos hídricos a dist ` | ancia, mas ˆ
tambem contribuiu para o aprimoramento de dispositivos IoT ´ que visam atender demandas ambientais de vigilancia remota. ˆ
| AGRADECIMENTOS
Agradeço ao meu orientador, Prof. Decio Renn ´ | o, por sua ´
dedicaçao, paci ˜ | encia e valiosas contribuiç ˆ | oes ao longo do ˜
desenvolvimento deste trabalho. Sua orientaçao foi essencial ˜ para a superaçao dos desafios enfrentados. ˜
Sou grato a Telit Cinterion por fornecer os recursos usados ` na realizaçao deste projeto, bem como aos colegas de trabalho ˜ pelo auxílio prestado durante o desenvolvimento.
Por fim, agradeço a minha fam ` | ília pelo apoio incondi-
cional, confiança e incentivo, que foram fundamentais para
a conclusao deste trabalho. Em especial, agradeço ˜ | a minha `
namorada, Maria Eduarda, por estar sempre ao meu lado me ajudando a enfrentar os desafios.
| REFERENCIAS ˆ
[1] MOUHA, Radouan Ait Radouan Ait et al. Internet of things (IoT). Journal of Data Analysis and Information Processing, v. 9, n. 02, p. 77, 2021.
[2] ABRAHAM, Shiny; BEARD, Joshua; MANIJACOB, Renjith. Remote environmental monitoring using Internet of Things (IoT). 2017 IEEE Global Humanitarian Technology Conference (GHTC). IEEE, 2017.
p. 1-6.
[3] CARRION, Patrícia et al. Internet da Coisas (IoT): Definiçoes e aplica- ˜
bilidade aos usuarios finais. ´ | Human Factors in Design, v. 8, n. 15, p.
049-066, 2019.
[4] BATTISTELLE, Rosane Aparecida Gomes et al. Industria 4.0 e sus- ´
tentabilidade: Uma aplicaçao da internet das coisas (iot) na proteç ˜ | aõ
ambiental. IX ENSUS – Encontro de Sustentabilidade em Projeto, UFSC. 2021.
[5] BRASIL, Jose et al. ´ Nature-based solutions and real-time control: Challenges and Opportunities. Water, v. 13, n. 5, p. 651, 2021. Disponível em: https://www.mdpi.com/2073-4441/13/5/651. Acesso em: 11 nov. 2024.
[6] SANTOS, Gilmar O.; HERNANDEZ, Fernando BT. Uso do solo
e monitoramento dos recursos hídricos no corrego do Ip ´ | e, Ilha ˆ
Solteira, SP. Revista Brasileira de Engenharia Agrícola e Ambiental, v. 17, p. 60-68, 2013. Disponível em: https://doi.org/10.1590/S1415-43662013000100009. (https://doi.org/10.1590/S1415-43662013000100009) Acesso em: 14 dez. 2024.
[7] AMERICO-PINHEIRO, J. H. P.; BENINI, S. M. Monitoramento de ´
recursos hídricos e parametros de qualidade de ˆ | agua em bacias ´
hidrograficas. Bacias hidrogr ´ | aficas: fundamentos e aplicaç ´ | oes, v. 2, p. ˜
204, 2018.
[8] STILLER, Burkhard et al. An overview of network communication technologies for IoT. Handbook of Internet-of-Things, v. 12, 2020.
[9] PERUMAL, Thinagaran; SULAIMAN, Md Nasir; LEONG, Chui Yew. Internet of Things (IoT) enabled water monitoring system. 2015 IEEE 4th Global Conference on Consumer Electronics (GCCE). IEEE, 2015. p. 86-87.
[10] ULLO, Silvia Liberata; SINHA, Ganesh Ram. Advances in smart environment monitoring systems using IoT and sensors. Sensors, v. 20,
n. 11, p. 3113, 2020.
[11] FREITAS, Arnold de Araujo. A internet das coisas e seus efeitos na industria 4.0. 2017. ´
[12] TEXAS INSTRUMENTS. Ultrasonic Sensing Basics: Application Note. Rev. D, 2019. 15 p. Disponível em: https://www.ti.com/lit/an/slaa907d/slaa907d.pdf. (https://www.ti.com/lit/an/slaa907d/slaa907d.pdf) Acesso em: 11 nov. 2024.
[13] CRAMER, Owen. The variation of the specific heat ratio and the speed of sound in air with temperature, pressure, humidity, and CO2 concentration. The Journal of the Acoustical Society of America, v. 93, ed. 5, p. 2510-2516, Maio 1993. Disponível em: https://doi.org/10.1121/1.405827. (https://doi.org/10.1121/1.405827) Acesso em: 7 nov. 2024.
[14] ONOMONDO. LTE Cat 1 bis: An ultimate guide with practical examples. 3 maio 2023. Disponível em: https://onomondo.com/blog/what-is-lte-cat-1-bis-and-why-is-it-good-for-iot/. (https://onomondo.com/blog/what-is-lte-cat-1-bis-and-why-is-it-good-for-iot/) Acesso em: 10 nov. 2024.
[15] NOCE, Lucas A. Level Sensing Device. 2024. Disponível em: https: //github.com/lucasnoce/TFG LevelSensingDevice. (https://github.com/lucasnoce/TFG_LevelSensingDevice) Acesso em: 11 nov. 2024.
[16] FABIAN ENTERPRISES. Arduino Distance Measuring Transducer Sensor Model:AJ-SR04M: User Manual. 2023. 4 p. Disponível em: https://www.fabian.com.mt/viewer/42585/pdf.pdf. Acesso em: 4 nov. 2024.
[17] DA | SILVA, | Guilherme | Melo; | DE | CARVALHO | BUENO,
Rafael; BLENINGER, Tobias. Desenvolvimento de um sensor
ultrassonico para mediç ˆ | ao cont ˜ | ínua do nível da agua de corpos ´
d’agua e uma an ´ | | alise da influ ´ | encia da temperatura do ar, 2024. ˆ
Disponível | em: | https://files.abrhidro.org.br/Eventos/Trabalhos/239/
II-FLUHIDROS0088-1-0-20240729-131840.pdf. (https://files.abrhidro.org.br/Eventos/Trabalhos/239/II-FLUHIDROS0088-1-0-20240729-131840.pdf) Acesso em: 8 nov. 2024.
[18] GIACOMO, P. Equation for the Determination of the Density of Moist Air (1981). Metrologia, Sevres, França, v. 18, ed. 1, p. 33-40, 7 ` jan. 1982. DOI 10.1088/0026-1394/18/1/006. Disponível em: https: //iopscience.iop.org/article/10.1088/0026-1394/18/1/006. Acesso em: 10 nov. 2024.
[19] AOSONG. Data Sheet AHT20: Humidity and Temperature Sensor. V1.0. 2021. 16 p. Disponível em: https://www.lcsc.com/datasheet/lcsc datasheet 2310231158 Aosong--Guangzhou-Elec-AHT20 C2757850. pdf. (https://www.lcsc.com/datasheet/lcsc_datasheet_2310231158_Aosong--Guangzhou-Elec-AHT20_C2757850.pdf) Acesso em: 4 nov. 2024.
[20] TELIT CINTERION. LE910R1: Hardware Design Guide. Rev 8. 2023. 82 p. Disponível em: https://www.telit.com/le910r1-download-zone/. Acesso em: 4 nov. 2024.
[21] 3rd Generation Partnership Project. 3GPP TS 36.101. v. 13.25.0, 2023. Disponível em: https://portal.3gpp.org/desktopmodules/Specifications/SpecificationDetails.aspx?specificationId=2411. (https://portal.3gpp.org/desktopmodules/Specifications/SpecificationDetails.aspx?specificationId=2411) Acesso em: 7 nov. 2024.
[22] STMICROELECTRONICS. | Datasheet | - | STM32F103x8
STM32F103xB: Medium-density performance line Arm®-based 32-bit MCU with 64 or 128 KB Flash, USB, CAN, 7 timers, 2 ADCs, 9 com. interfaces. Rev 19. 2023. 114 p. Disponível em: https://www.st.com/resource/en/datasheet/stm32f103rb.pdf. Acesso em: 4 nov. 2024.
[23] TEXAS INSTRUMENTS. TLV1117 Adjustable and Fixed Low-Dropout Voltage Regulator. Rev M. Dallas, Texas, 2023. 40 p. Disponível em: https://www.ti.com/lit/ds/symlink/tlv1117.pdf. Acesso em: 4 nov. 2024.
[24] TEXAS INSTRUMENTS. TXS0102 2-Bit Bidirectional Voltage-Level Translator for Open-Drain and Push-Pull Applications. Rev J. Dallas, Texas, 2023. 39 p. Disponível em: https://www.ti.com/lit/ds/symlink/txs0102.pdf. (https://www.ti.com/lit/ds/symlink/txs0102.pdf) Acesso em: 11 nov. 2024.
[25] Tech Public. AO3401A: P-Channel Enhancement Mode Power MOS-FET. 2024. 6 p. Disponível em: https://www.lcsc.com/datasheet/lcsc datasheet 2208111730 TECH-PUBLIC-AO3401A C5122001.pdf. (https://www.lcsc.com/datasheet/lcsc_datasheet_2208111730_TECH-PUBLIC-AO3401A_C5122001.pdf) Acesso em: 11 nov. 2024.
[26] Tech Public. NDS331N: 20V N-Channel Mosfet. 2024. 5 p. Disponível
em: | https://www.lcsc.com/datasheet/lcsc datasheet 2304031730
TECH-PUBLIC-NDS331N C5123903.pdf. (https://www.lcsc.com/datasheet/lcsc_datasheet_2304031730_TECH-PUBLIC-NDS331N_C5123903.pdf) Acesso em: 9 nov. 2024.
[27] JLCPCB. PCB Impedance Calculator. 2024. Disponível em: https://jlcpcb.com/pcb-impedance-calculator. Acesso em: 9 nov. 2024.

APENDICE ˆ | A
SUBCIRCUITO DE ALIMENTAÇ AÕ

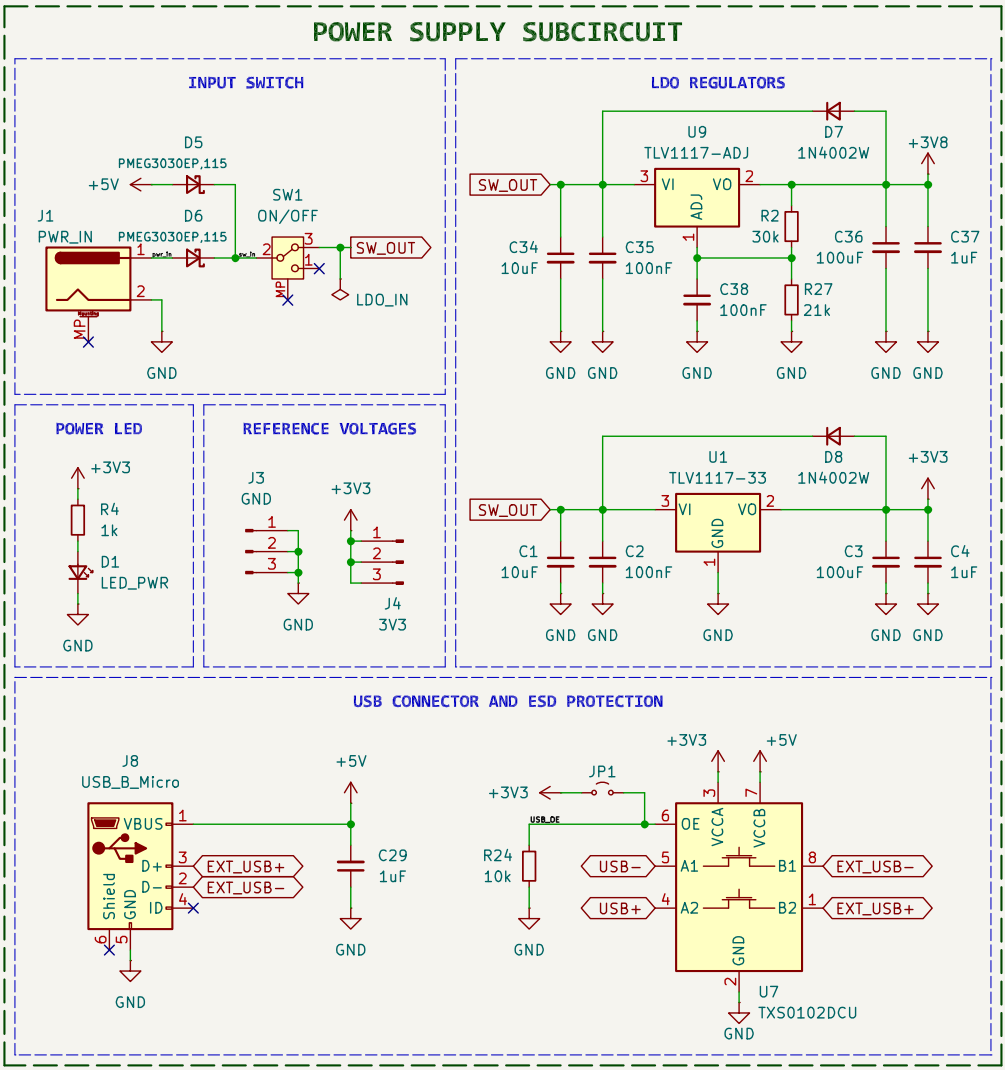
[picture p8: figure]

APENDICE ˆ | B

SUBCIRCUITO DO MICROCONTROLADOR

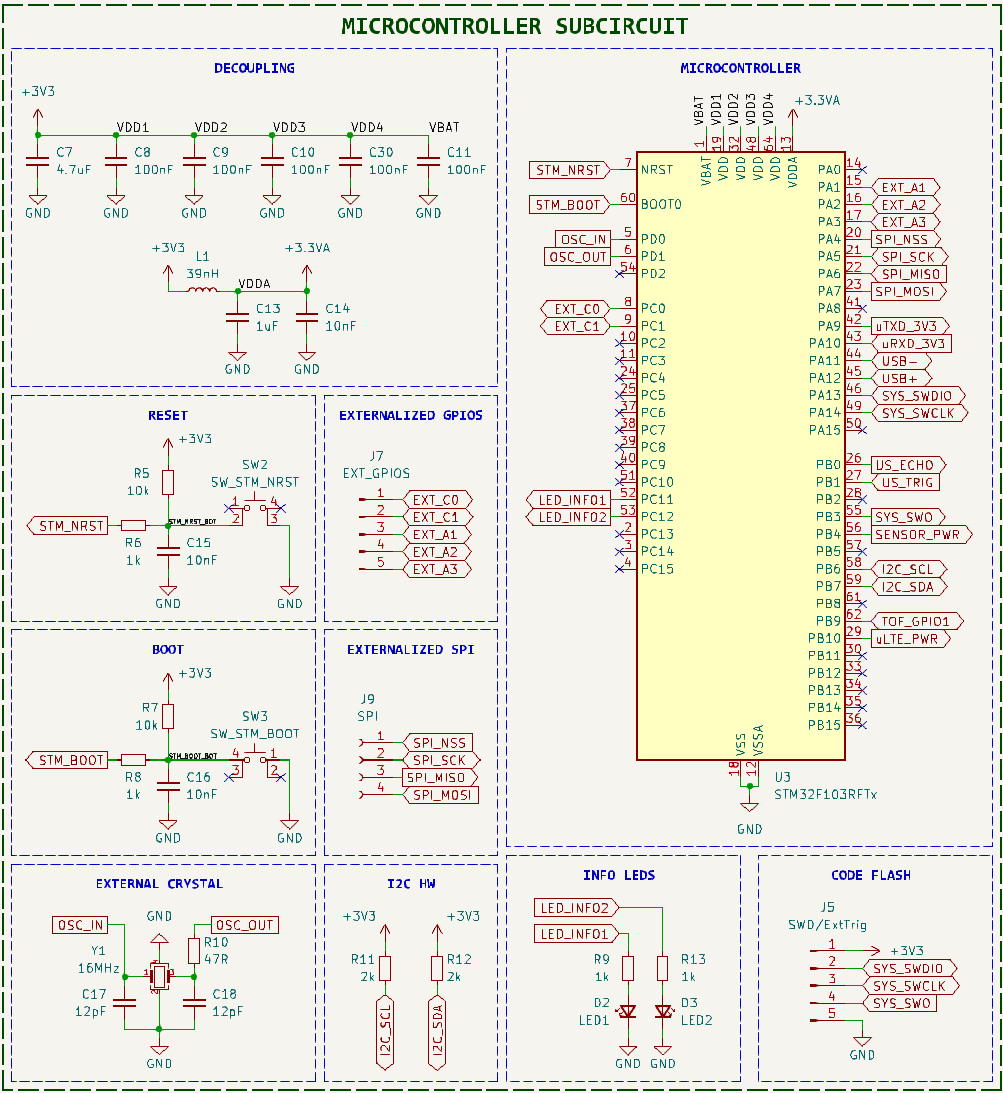
[picture p9: figure]

APENDICE ˆ | C

SUBCIRCUITO DOS SENSORES

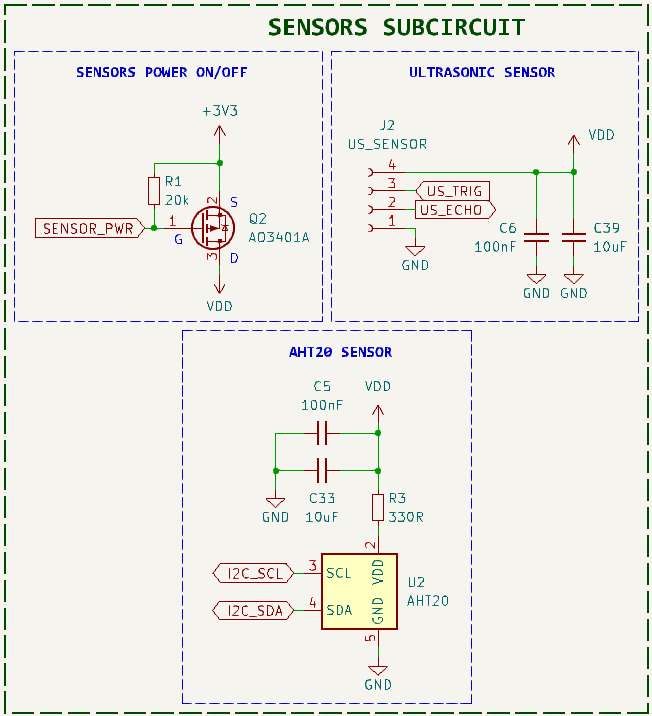
[picture p10: figure]

APENDICE ˆ | D

SUBCIRCUITO DO MODEM

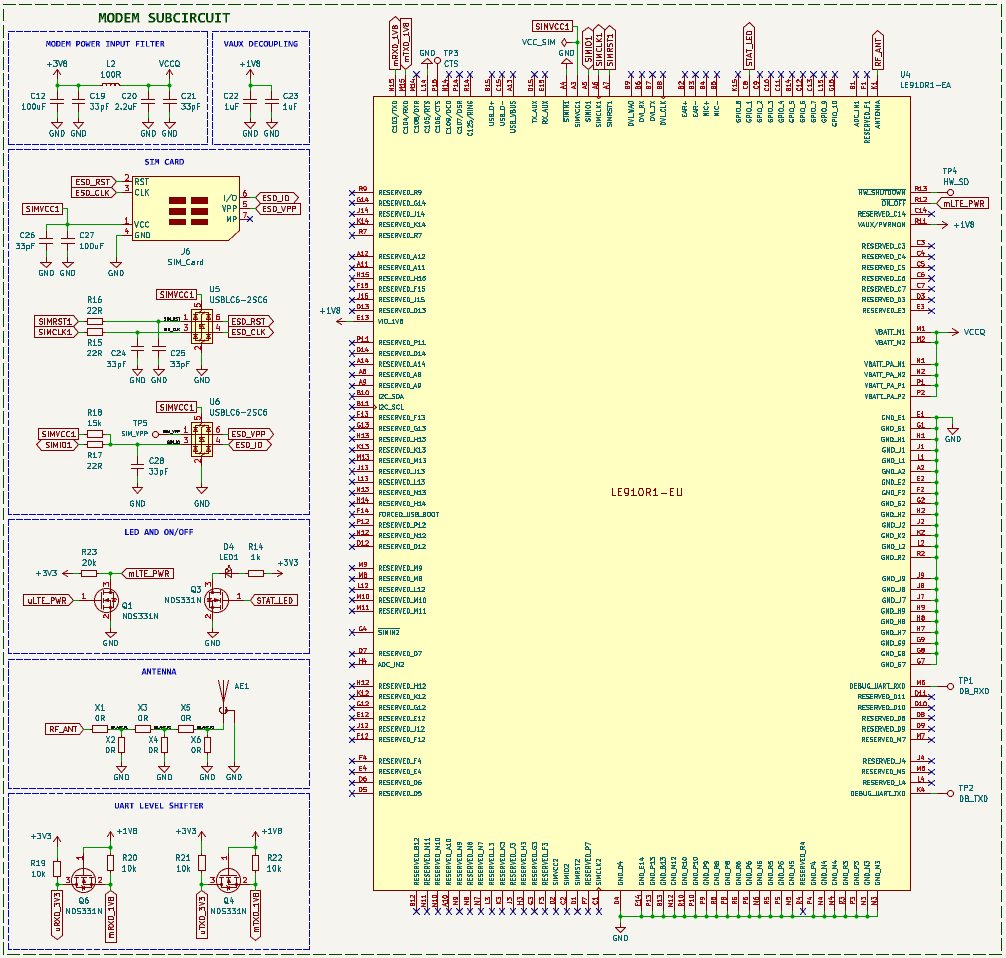
[picture p11: figure]
