lucasnoce/TFG_LevelSensingDevice/Core/Src/main.c

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
/* Includes ------------------------------------------------------------------*/
#include "main.h"
#include "usb_device.h"

/* USER CODE BEGIN Includes */
#include "MyDriversInc/lsd_config.h"
#include "MyDriversInc/global_var.h"
#include "usbd_cdc_if.h"
//#include "MyDriversInc/leds.h"
//#include "MyDriversInc/aht20.h"
//#include "MyDriversInc/ajsr04m.h"
//#include "MyDriversInc/le910r1br.h"
#include "MyServicesInc/state_machine.h"
/* USER CODE END Includes */

I2C_HandleTypeDef hi2c1;

RTC_HandleTypeDef hrtc;

TIM_HandleTypeDef htim2;
TIM_HandleTypeDef htim3;
TIM_HandleTypeDef htim4;

UART_HandleTypeDef huart1;
UART_HandleTypeDef huart2;

/* USER CODE BEGIN PV */
static LSD_MCU_PERIPH_HANDLES_T hmcu_peripherals;
/* USER CODE END PV */

void SystemClock_Config(void);
static void MX_GPIO_Init(void);
static void MX_TIM2_Init(void);
static void MX_TIM3_Init(void);
static void MX_I2C1_Init(void);
static void MX_TIM4_Init(void);
static void MX_USART1_UART_Init(void);
static void MX_RTC_Init(void);
static void MX_USART2_UART_Init(void);
/**
  * @brief  The application entry point.
  * @retval int
  */
int main(void)
{

  /* MCU Configuration--------------------------------------------------------*/

  /* Reset of all peripherals, Initializes the Flash interface and the Systick. */
  HAL_Init();

  /* Configure the system clock */
  SystemClock_Config();

  /* Initialize all configured peripherals */
  MX_GPIO_Init();
  MX_TIM2_Init();
  MX_TIM3_Init();
  MX_I2C1_Init();
  MX_TIM4_Init();
  MX_USART1_UART_Init();
  MX_RTC_Init();
  MX_USB_DEVICE_Init();
  MX_USART2_UART_Init();
  /* USER CODE BEGIN 2 */

  hmcu_peripherals.mcu_hi2c = &hi2c1;
  hmcu_peripherals.mcu_htim[LSD_TIM_GENERAL] = &htim2;
  hmcu_peripherals.mcu_htim[LSD_TIM_COMMON] = &htim3;
  hmcu_peripherals.mcu_htim[LSD_TIM_SENSORS] = &htim4;
  hmcu_peripherals.mcu_huart[LSD_UART_MODEM] = &huart1;
  hmcu_peripherals.mcu_huart[LSD_UART_FTDI] = &huart2;
  hmcu_peripherals.mcu_hrtc = &hrtc;

  state_machine_init( &hmcu_peripherals, &SystemClock_Config );


//	HAL_Delay( 2000 );
//	leds_turn_on( LSD_LED_BLUE );
//	le910r1br_power_on();
//	leds_turn_off( LSD_LED_BLUE );
//	HAL_Delay( 11000 );

  /* USER CODE END 2 */

  /* Infinite loop */
  /* USER CODE BEGIN WHILE */
  while (1)
  {
    /* USER CODE END WHILE */

    /* USER CODE BEGIN 3 */
	state_machine_run();

//	HAL_UART_Transmit( &huart1, modem_tx, 5, 1000 );
//	HAL_UART_Receive( &huart1, modem_rx, 64, 1000 );
//
//	CDC_Transmit_FS( modem_rx, strlen( (char *) modem_rx ) );
////	ret = ajsr04m_read_tof_blocking( 10000 );
//	HAL_Delay( 1000 );
  }
  /* USER CODE END 3 */
}

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
