lucasnoce/TFG_LevelSensingDevice/Core/Inc/main.h

#define LSD_BUF_SIZE	64
#define US_ECHO_Pin GPIO_PIN_0
#define US_ECHO_GPIO_Port GPIOB
#define US_ECHO_EXTI_IRQn EXTI0_IRQn
#define US_TRIG_Pin GPIO_PIN_1
#define US_TRIG_GPIO_Port GPIOB
#define uLTE_PWR_Pin GPIO_PIN_10
#define uLTE_PWR_GPIO_Port GPIOB
#define LED_INFO1_Pin GPIO_PIN_11
#define LED_INFO1_GPIO_Port GPIOC
#define LED_INFO2_Pin GPIO_PIN_12
#define LED_INFO2_GPIO_Port GPIOC
#define SENSOR_PWR_Pin GPIO_PIN_4
#define SENSOR_PWR_GPIO_Port GPIOB
