lucasnoce/TFG_LevelSensingDevice/Core/Inc/MyServicesInc/lte_transmission.h

/*
 * lte_transmissions.h
 *
 *  Created on: Nov 3, 2024
 *      Author: lucas
 */

#ifndef INC_MYSERVICESINC_LTE_TRANSMISSION_H_
#define INC_MYSERVICESINC_LTE_TRANSMISSION_H_

void lsd_transmit_lte( void );

#endif /* INC_MYSERVICESINC_LTE_TRANSMISSION_H_ */
