lucasnoce/TFG_LevelSensingDevice/(commit log)

2024-12-02 Added UART2 logging support
2024-12-02 Fixed USB init issues
    [leds.h, state_machine.c]
